Moonlight63/JGMaker_Artist-D_Mods/README.md

# JGMaker_Artist-D_Mods

A small and evolving collection of modifications that I am making to my JGMaker Artist-D Pro.
