Moonlight63/JGMaker_Artist-D_Mods/Better Right Extruder Mount/STEP/MGN_Mount.stp

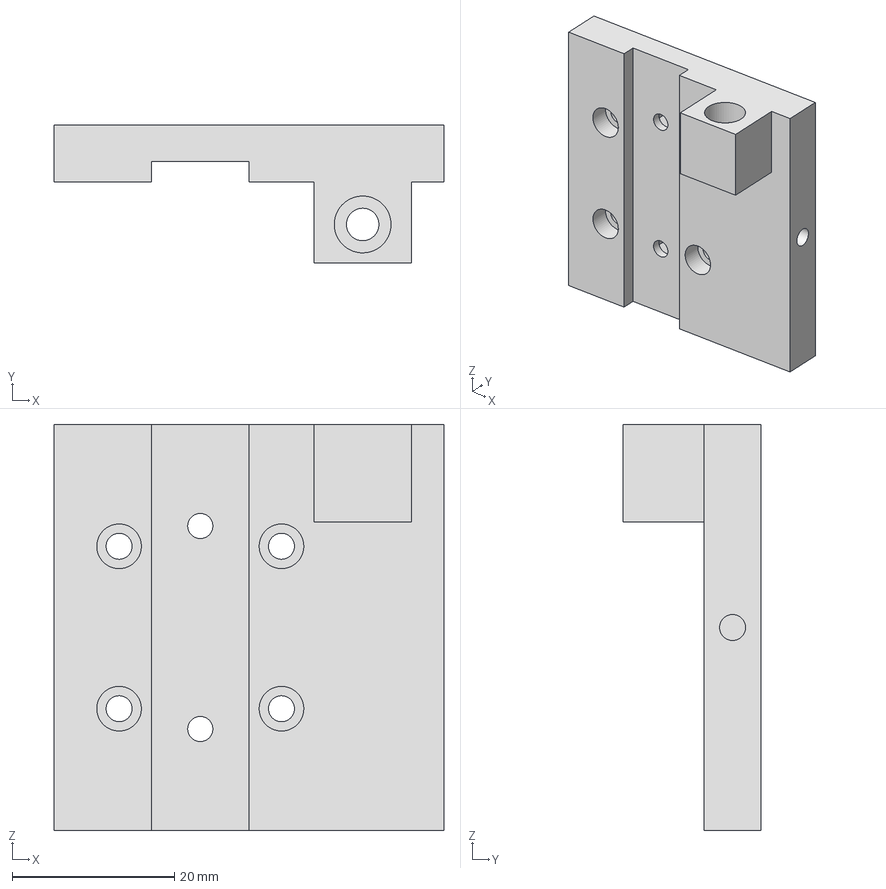
[picture p2: CAD file, 2021-07-09]
Better Right Extruder Mount/STEP/MGN_Mount.stp
48.0 x 17.0 x 50.0 mm
