Moonlight63/JGMaker_Artist-D_Mods/Better Right Extruder Mount/STEP/mgn_screw_nut.stp

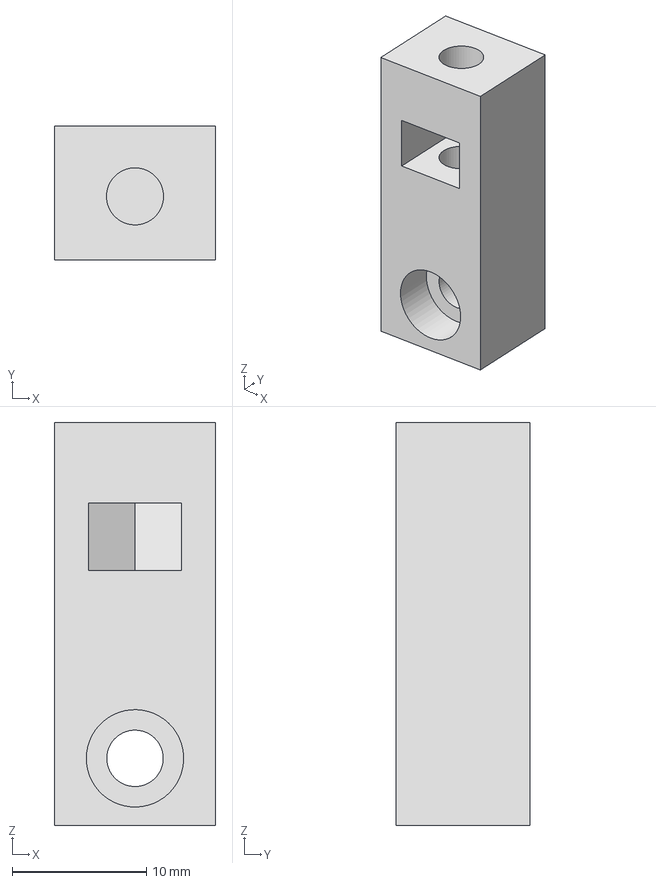
[picture p3: CAD file, 2021-07-09]
Better Right Extruder Mount/STEP/mgn_screw_nut.stp
12.0 x 10.0 x 30.0 mm
