Moonlight63/JGMaker_Artist-D_Mods/(list of files, cad)

Other CAD files:
Better Right Extruder Mount/Inventor/Right_Extruder_Mount/MGN_Mount.ipt
Better Right Extruder Mount/Inventor/Right_Extruder_Mount/Master.ipt
Better Right Extruder Mount/Inventor/Right_Extruder_Mount/mgn_assy.iam
Better Right Extruder Mount/Inventor/Right_Extruder_Mount/mgn_screw_nut.ipt
Better Right Extruder Mount/STL/MGN_Mount.stl
Better Right Extruder Mount/STL/mgn_screw_nut.stl
