Moonlight63/JGMaker_Artist-D_Mods/Better Right Extruder Mount/Top_View.jpg

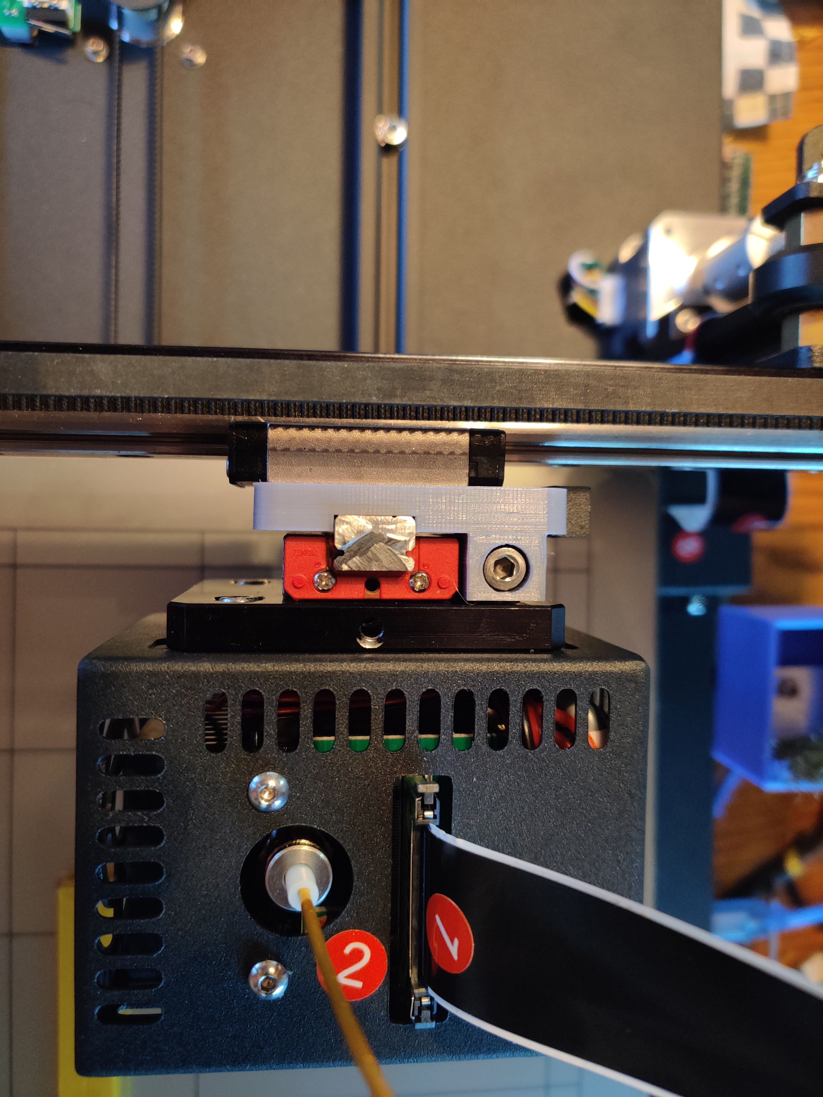
[picture p1: Better Right Extruder Mount/Top_View.jpg]
Better Right Extruder Mount/Top_View.jpg
